Paul-3400/INA-226-monitor-v2/(commit log)

2026-10-08 Update wiring components in README.md
2026-10-08 Update components list in README
    Replaced soldering tools with PCB and spacers in the components list.
2026-10-08 Update component description for M2 spacers
2026-10-08 Revise wiring diagram in README
    Updated wiring diagram for clarity and corrected formatting.
